ISpeak2myHouse/ISpeak2myHouseRoot/Mechanical/Mechanical Design.pptx

## Mechanical Design

Wearable Device

## Slide 2

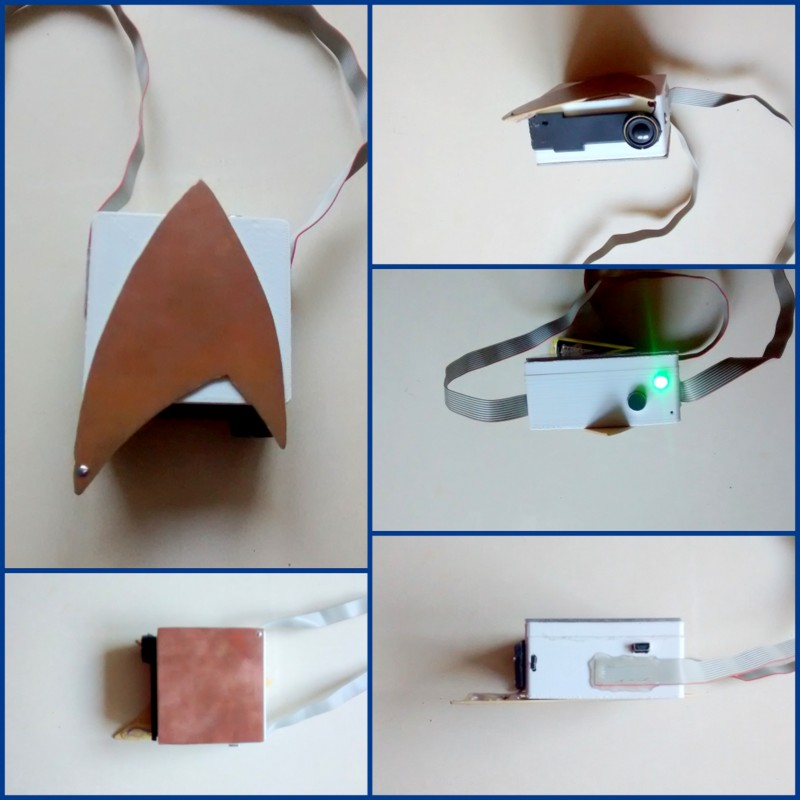
[picture p1: figure]

FRONT VIEW

BOTTOM VIEW

TOP VIEW
(with LED)

BACK VIEW

SIDE VIEW
