ISpeak2myHouse/ISpeak2myHouseRoot/Hardware/FINAL/PCBv1.3/01072016wearable_v1.3 - OK.html

Partlist exported from D:/Mes Documents/03 - Freiburg Universitaet/06 - Kurse/SS16/06 - Embedded Systems/02 - HW/01 - Wearable/FINAL/PCBv1.3/01072016wearable_v1.3 - OK.sch at 11/07/2016 17:32

Part | Value | Device | Package | Description | MF | MPN | OC_FARNELL | OC_NEWARK
BAT | | MA03-1 | MA03-1 | PIN HEADER | | | unknown | unknown
BUTIN | LSP10 | LSP10 | LSP10 | SOLDER PAD drill 1.0 mm, distributor Buerklin, 12H555
C1 | 0.1u | C2.5/2 | C2.5-2 | CAPACITOR
C2 | 0.1u | C2.5/2 | C2.5-2 | CAPACITOR
CAPIN | LSP10 | LSP10 | LSP10 | SOLDER PAD drill 1.0 mm, distributor Buerklin, 12H555
D1 | BAT54C | BAT54C | SOT23 | Schottky Diodes
IC1 | NCS2211 | NCS2211 | SOIC-8
IC2 | TEENSY_3.1_OUTER_ROW | TEENSY_3.1_OUTER_ROW | TEENSY3-OUTER_ROW | Footprint for Teensy 3.1 or 3.2 board using all pin connections on the outer perimeter
LED1 | 5MMRGBLED | 5MMRGBLED | LED5MMRGB
LS+ | LSP10 | LSP10 | LSP10 | SOLDER PAD drill 1.0 mm, distributor Buerklin, 12H555
LS- | LSP10 | LSP10 | LSP10 | SOLDER PAD drill 1.0 mm, distributor Buerklin, 12H555
MIC_IN | | MA05 | 05PA | AMP QUICK CONNECTOR | | | unknown | unknown
NRF24 | | MA04-2 | MA04-2 | PIN HEADER | | | unknown | unknown
P7 | LSP10 | LSP10 | LSP10 | SOLDER PAD drill 1.0 mm, distributor Buerklin, 12H555
P8 | LSP10 | LSP10 | LSP10 | SOLDER PAD drill 1.0 mm, distributor Buerklin, 12H555
P10 | LSP10 | LSP10 | LSP10 | SOLDER PAD drill 1.0 mm, distributor Buerklin, 12H555
P18 | LSP10 | LSP10 | LSP10 | SOLDER PAD drill 1.0 mm, distributor Buerklin, 12H555
P23 | LSP10 | LSP10 | LSP10 | SOLDER PAD drill 1.0 mm, distributor Buerklin, 12H555
R1 | 20k | R-EU_0204/7 | 0204/7 | RESISTOR, European symbol
R2 | 100 | R-EU_0207/2V | 0207/2V | RESISTOR, European symbol
R3 | 100 | R-EU_0207/2V | 0207/2V | RESISTOR, European symbol
R4 | 100 | R-EU_0207/2V | 0207/2V | RESISTOR, European symbol
R5 | 10k | R-EU_0207/2V | 0207/2V | RESISTOR, European symbol
R6 | 10k | R-EU_0207/2V | 0207/2V | RESISTOR, European symbol
S1 | SWS002 | SWS002 | SMS-002 | SMD Dip Switch 2 pol.
SD1 | MICROSD_SF-MICROSD | MICROSD_SF-MICROSD | MICROSD_MICROSD
SW_IN1 | SE11 | SE11 | SE11 | SOLDER PAD RTM, drill 1,1mm, distributor Buerklin, 07F810
SW_IN2 | SE11 | SE11 | SE11 | SOLDER PAD RTM, drill 1,1mm, distributor Buerklin, 07F810
TRIMMER20K | | R-EU_0207/2V | 0207/2V | RESISTOR, European symbol
U$1 | TSOP4830 | TSOP4830 | TSOP18XX | IR Receiver and Demodulator
USB5V | LSP10 | LSP10 | LSP10 | SOLDER PAD drill 1.0 mm, distributor Buerklin, 12H555
