ISpeak2myHouse/ISpeak2myHouseRoot/Hardware/FINAL/02 - SolidWorks/Assemblage1.SLDASM

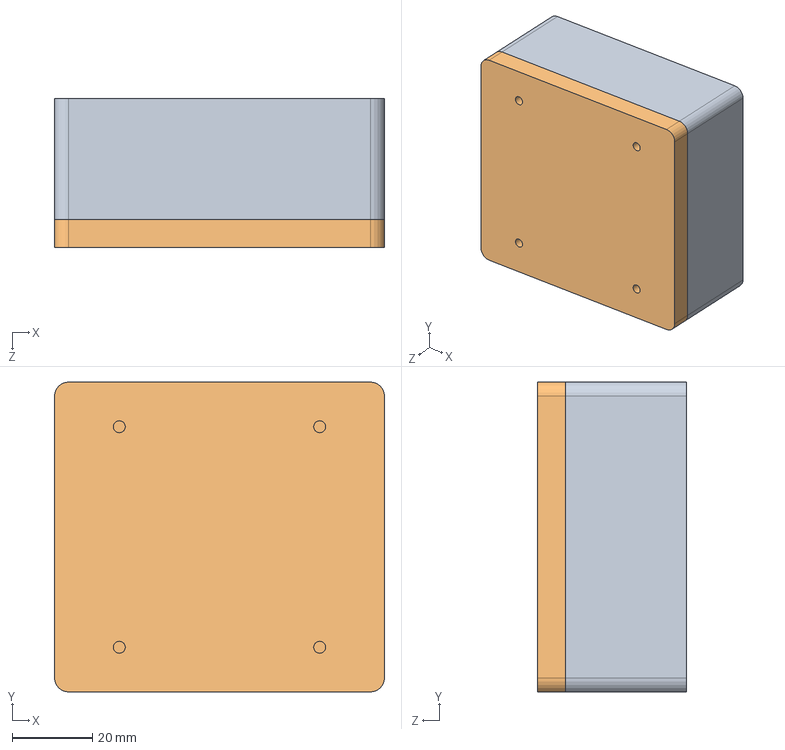
[picture p2: CAD file, 2016-08-07]
Hardware/FINAL/02 - SolidWorks/Assemblage1.SLDASM
82.0 x 77.0 x 37.0 mm
bottom
top
