ISpeak2myHouse/ISpeak2myHouseRoot/Hardware/FINAL/02 - SolidWorks/3D Printing/Ispeak2MyTop.STL

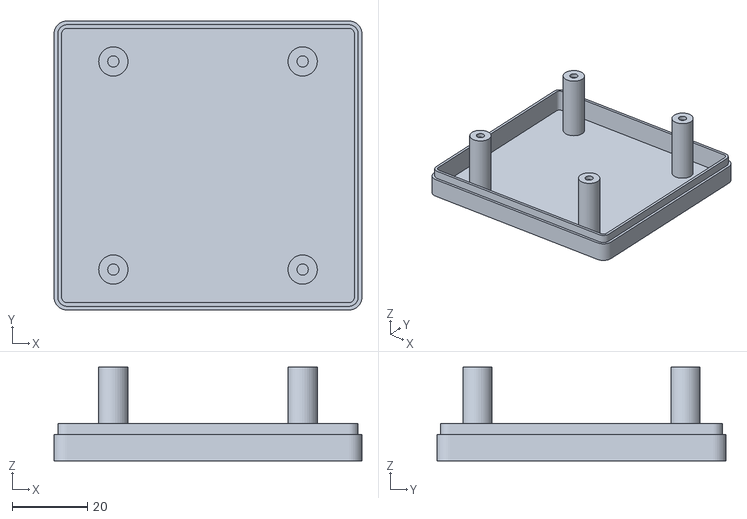
[picture p3: CAD file, 2016-08-07]
Hardware/FINAL/02 - SolidWorks/3D Printing/Ispeak2MyTop.STL
82.0 x 77.0 x 25.0
