ISpeak2myHouse/ISpeak2myHouseRoot/Hardware/FINAL/02 - SolidWorks/bottom.SLDPRT

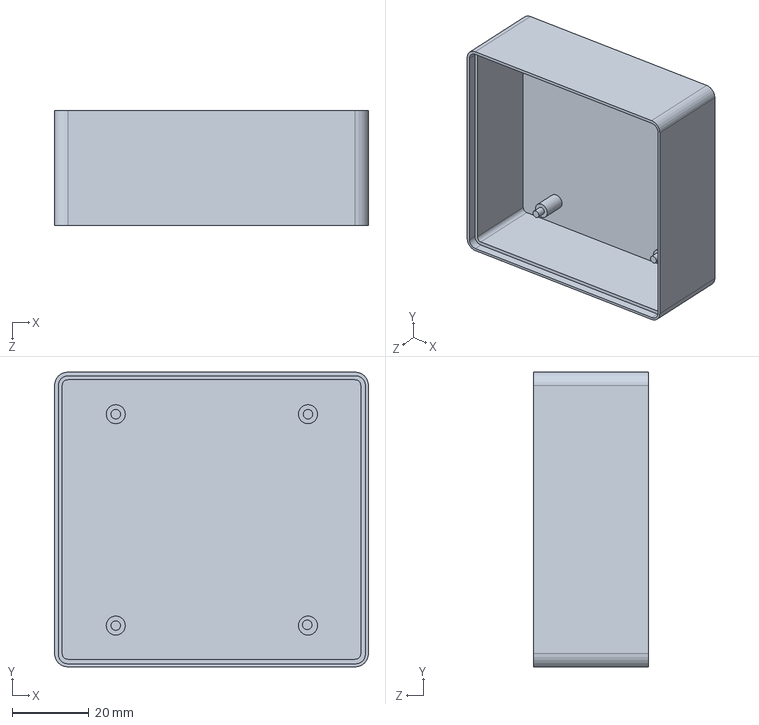
[picture p4: CAD file, 2016-08-07]
Hardware/FINAL/02 - SolidWorks/bottom.SLDPRT
82.0 x 77.0 x 30.0 mm
