ISpeak2myHouse/ISpeak2myHouseRoot/(list of files, cad)

Other CAD files:
Hardware/FINAL/02 - SolidWorks/top.SLDPRT
Hardware/FINAL/02 - SolidWorks/2D model.SLDDRW
Hardware/FINAL/02 - SolidWorks/3D Printing/bottom.STL
Hardware/FINAL/02 - SolidWorks/bottom.STL
Hardware/FINAL/02 - SolidWorks/top.STL
