ISpeak2myHouse/ISpeak2myHouseRoot/Hardware/FINAL/PCBv1.0/VIAs bottom view.pdf

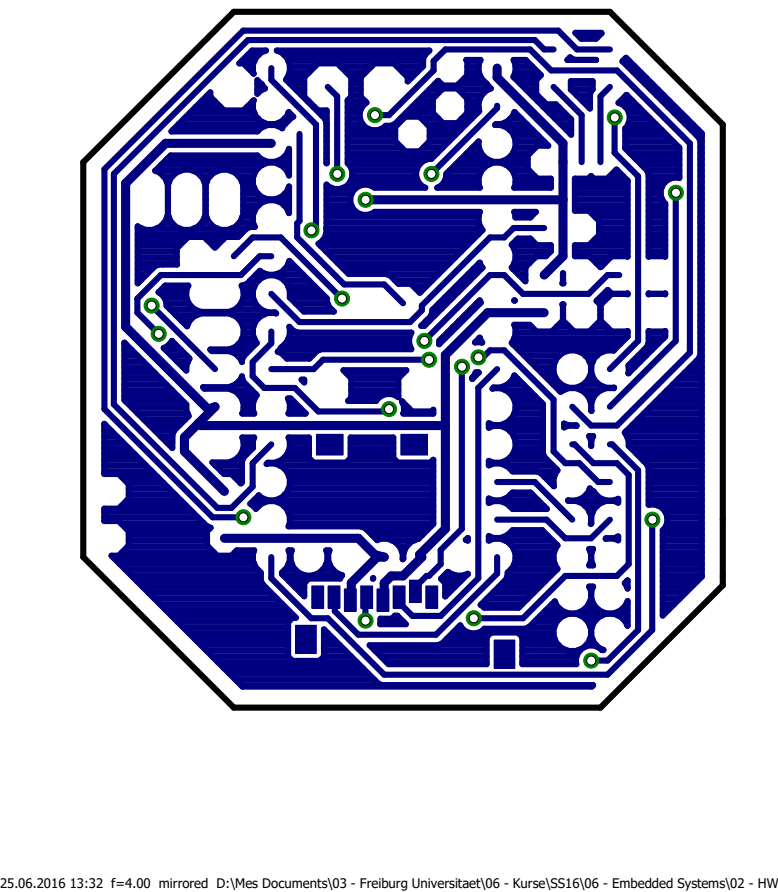
[picture p5: page 1]

25.06.2016 13:32 f=4.00 mirrored D:\Mes Documents\03 - Freiburg Universitaet\06 - Kurse\SS16\06 - Embedded Systems\02 - HW\01 - Wearable\FINAL\PCBv1.0\25062016wearable_v1.0.brd
