ISpeak2myHouse/ISpeak2myHouseRoot/Hardware/FINAL/PCBv1.0/VIAs top view.pdf

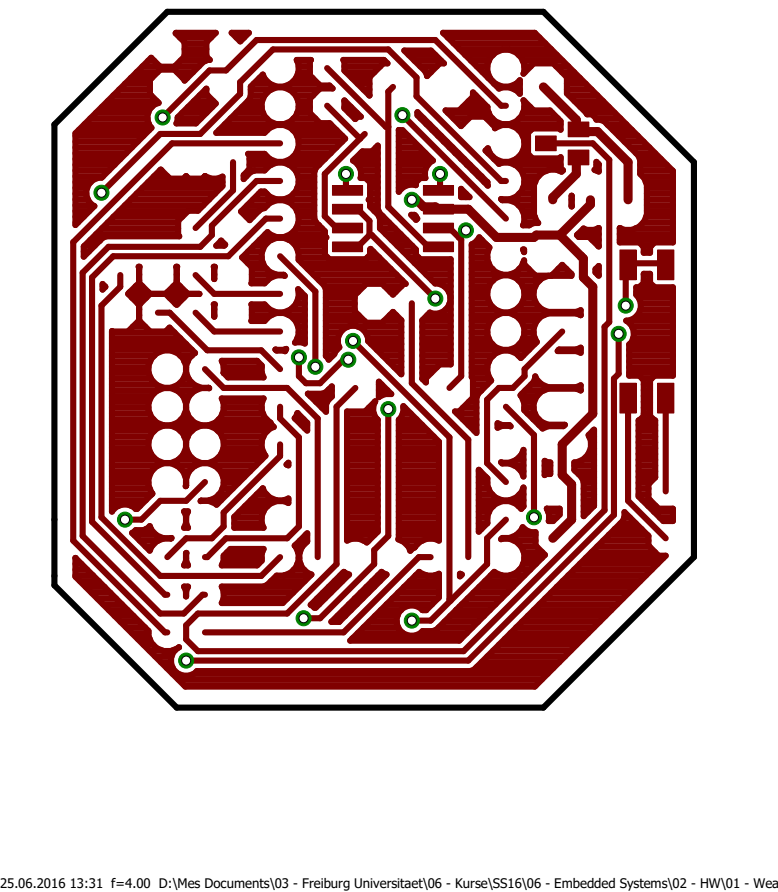
[picture p6: page 1]

25.06.2016 13:31 f=4.00 D:\Mes Documents\03 - Freiburg Universitaet\06 - Kurse\SS16\06 - Embedded Systems\02 - HW\01 - Wearable\FINAL\PCBv1.0\25062016wearable_v1.0.brd
