ISpeak2myHouse/ISpeak2myHouseRoot/Hardware/FINAL/PCBv1.0/wearable - components placement.pdf

# LED1

# LS+ LS- MIC_IN NRF24

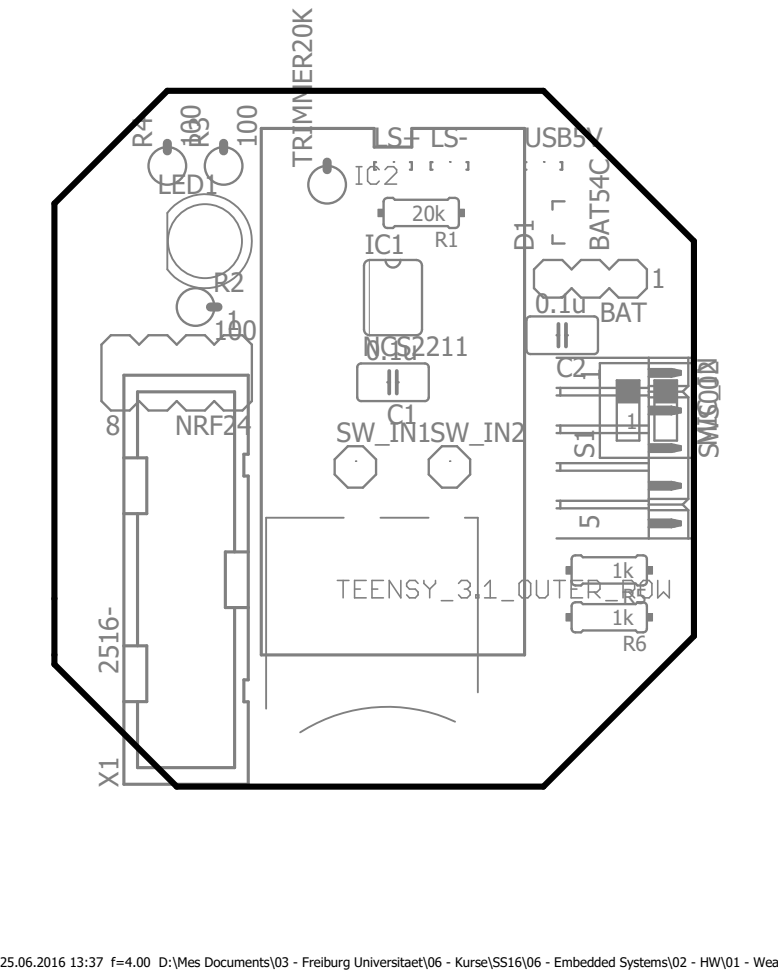
[picture p7: page 1]
BAT; R2 R⁴R³; SW_IN1SW_IN2 TRIMMER²⁰K; USB5V X1; 0.1u BAT54C; NCS2211; 100 ¹⁰⁰ ¹⁰⁰ 2516⁻; SWS002

25.06.2016 13:37 f=4.00 D:\Mes Documents\03 - Freiburg Universitaet\06 - Kurse\SS16\06 - Embedded Systems\02 - HW\01 - Wearable\FINAL\PCBv1.0\25062016wearable_v1.0.brd
