ISpeak2myHouse/ISpeak2myHouseRoot/Hardware/FINAL/PCBv1.0/wearable - Schematic.pdf

## IN- 4 EN

# X1-16 LS+ LS⁻ USB5V SW_IN¹ SW_IN²

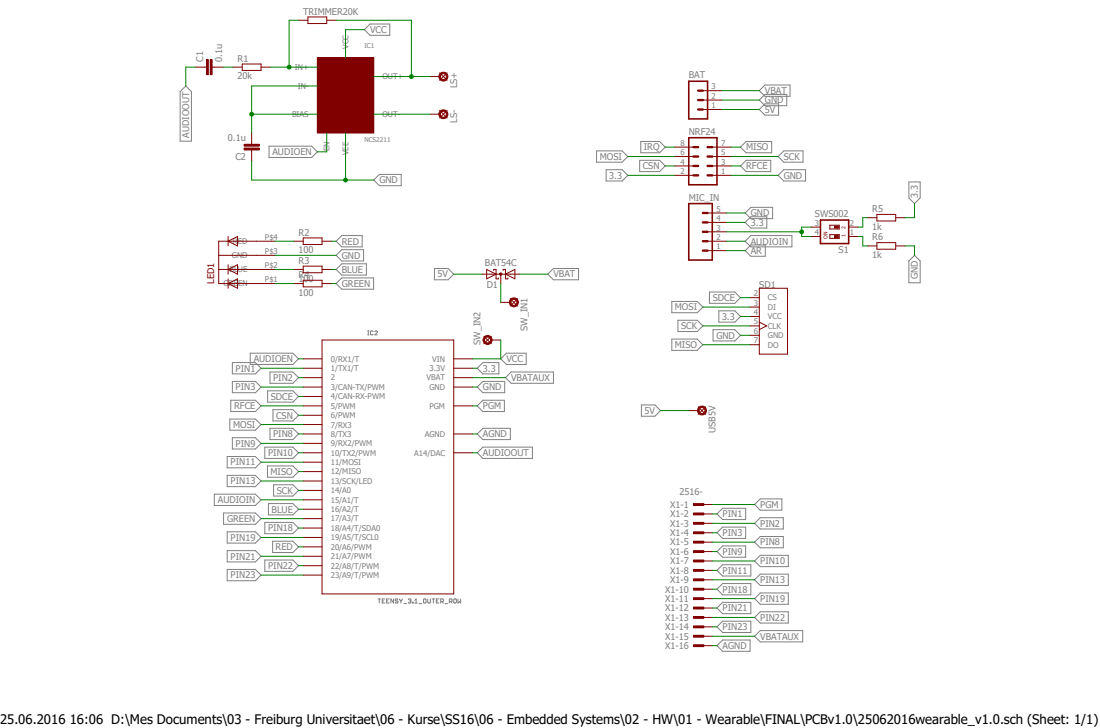
[picture p8: page 1]

25.06.2016 16:06 D:\Mes Documents\03 - Freiburg Universitaet\06 - Kurse\SS16\06 - Embedded Systems\02 - HW\01 - Wearable\FINAL\PCBv1.0\25062016wearable_v1.0.sch (Sheet: 1/1)
