ISpeak2myHouse/ISpeak2myHouseRoot/Hardware/FINAL/PCBv1.3/bottom.pdf

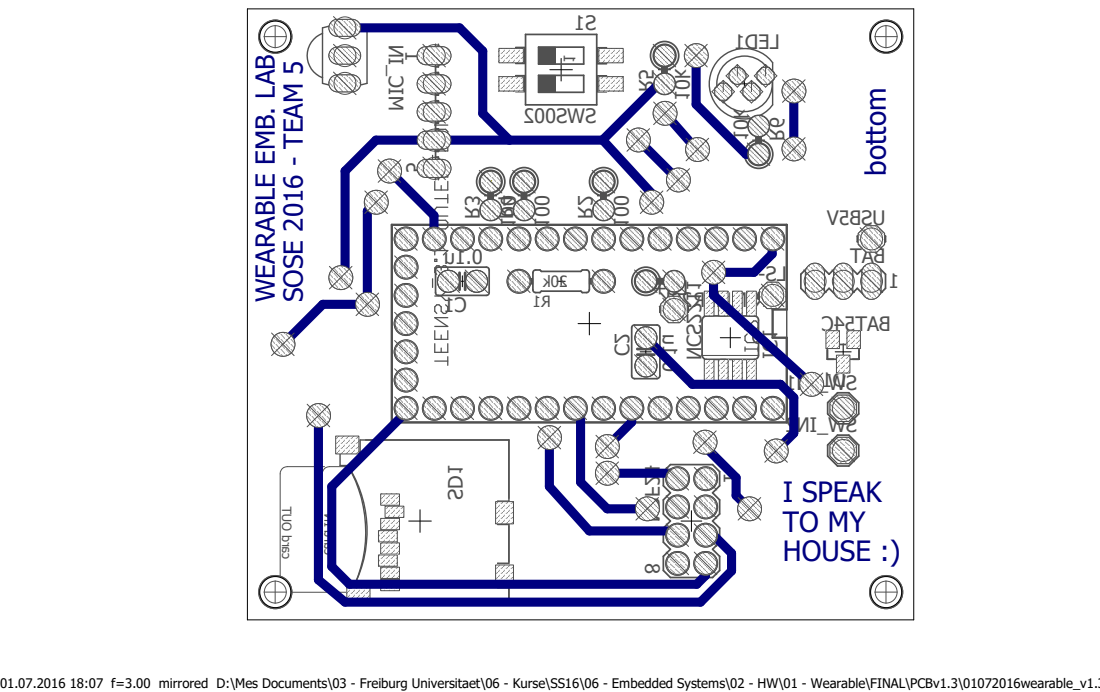
[picture p9: page 1]
I SPEAK TO MY HOUSE :)

1 bottom WEARABLE EMB. LAB SOSE 2016 - TEAM 5

01.07.2016 18:07 f=3.00 mirrored D:\Mes Documents\03 - Freiburg Universitaet\06 - Kurse\SS16\06 - Embedded Systems\02 - HW\01 - Wearable\FINAL\PCBv1.3\01072016wearable_v1.3 - OK.brd
