ISpeak2myHouse/ISpeak2myHouseRoot/Hardware/FINAL/PCBv1.3/Schematic.pdf

## IN- 4 EN

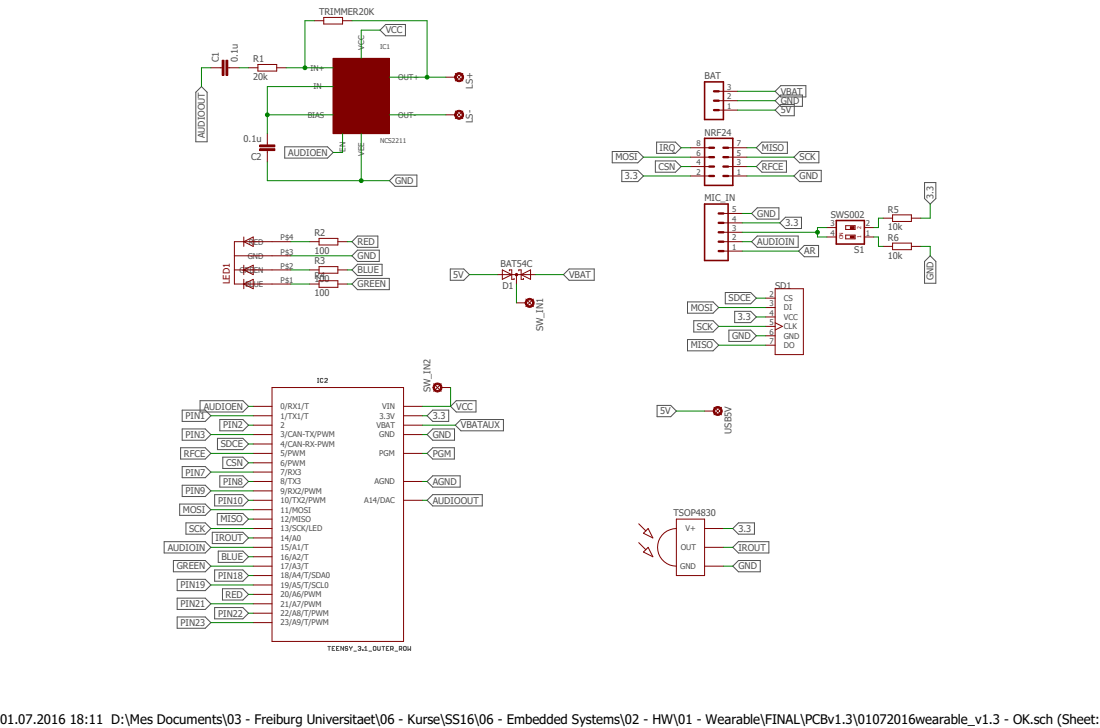
[picture p10: page 1]

01.07.2016 18:11 D:\Mes Documents\03 - Freiburg Universitaet\06 - Kurse\SS16\06 - Embedded Systems\02 - HW\01 - Wearable\FINAL\PCBv1.3\01072016wearable_v1.3 - OK.sch (Sheet: 1/1)
