ISpeak2myHouse/ISpeak2myHouseRoot/Hardware/FINAL/PCBv1.3/top.pdf

60.00

## LED1

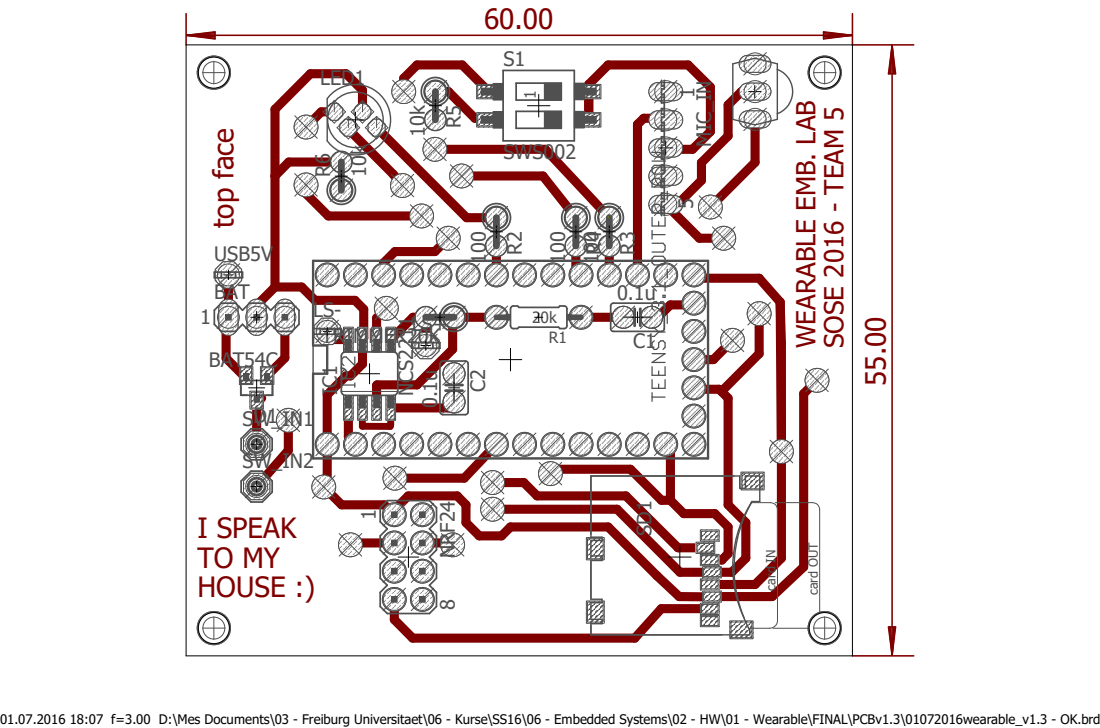
[picture p12: page 1]
01.07.2016 18:07 f=3.00 D:\Mes Documents\03 - Freiburg Universitaet\06 - Kurse\SS16\06 - Embedded Systems\02 - HW\01 - Wearable\FINAL\PCBv1.3\01072016wearable_v1.3 - OK.brd top face; WEARABLE EMB. LAB SOSE 2016 ⁻ TEAM ⁵ 55.00; I SPEAK TO MY HOUSE :); BAT; MIC_IN NRF24; R⁴R³ R⁵ R⁶; SD¹; TRIMMER20K; USB5V; BAT54C; NCS2211; 20k ¹⁰⁰; SWS002

1 card IN card OUT
