ISpeak2myHouse/ISpeak2myHouseRoot/Hardware/FINAL/02 - SolidWorks/final plan.pdf

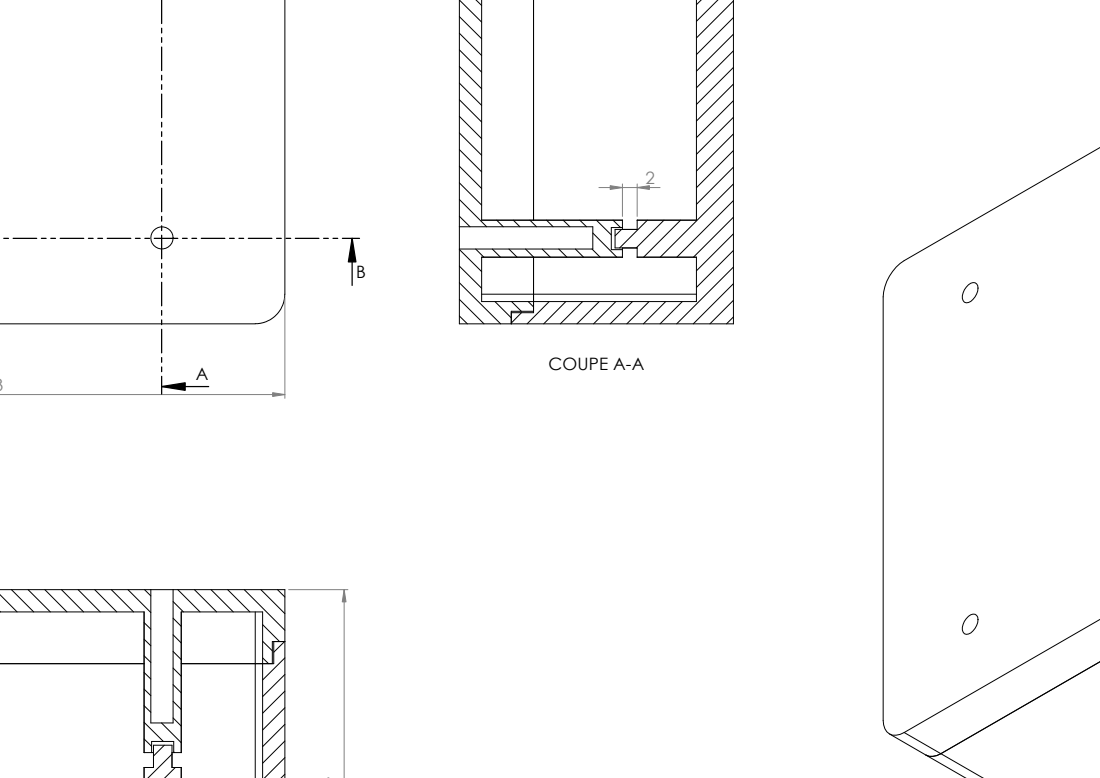
[picture p13: page 1]
COUPE A-A
