ISpeak2myHouse/ISpeak2myHouseRoot/LiFi transmission + schmitt trigger.asc

C1: cap; 0.1n
D2: schottky
R1: res; 50k
R2: res; 1k
R3: res; 3.3k
R4: res; 1k
R5: res; 100k
R6: res; 100k
R7: res; 50k
R8: res; 100k
U1: LT6202
U2: PC817C
U3: LT6202
V1: voltage; 3.3
V3: voltage; PULSE(0 0.1 0 0 0 0.0000005 0.000001 1000); AC 1
V4: voltage; PULSE(0 3.3 0 0 0 0.00005 0.0001 50)
Named nets: 0, V+, V-, Vin, Vk, Vout, Vschmitt
.tran 0.0002
