ISpeak2myHouse/ISpeak2myHouseRoot/Hardware/FINAL/PCBV1.1/25062016wearable_v1.2 - OK.brd

## EAGLE design Hardware/FINAL/PCBV1.1/25062016wearable_v1.2 - OK.brd (2016-08-07)

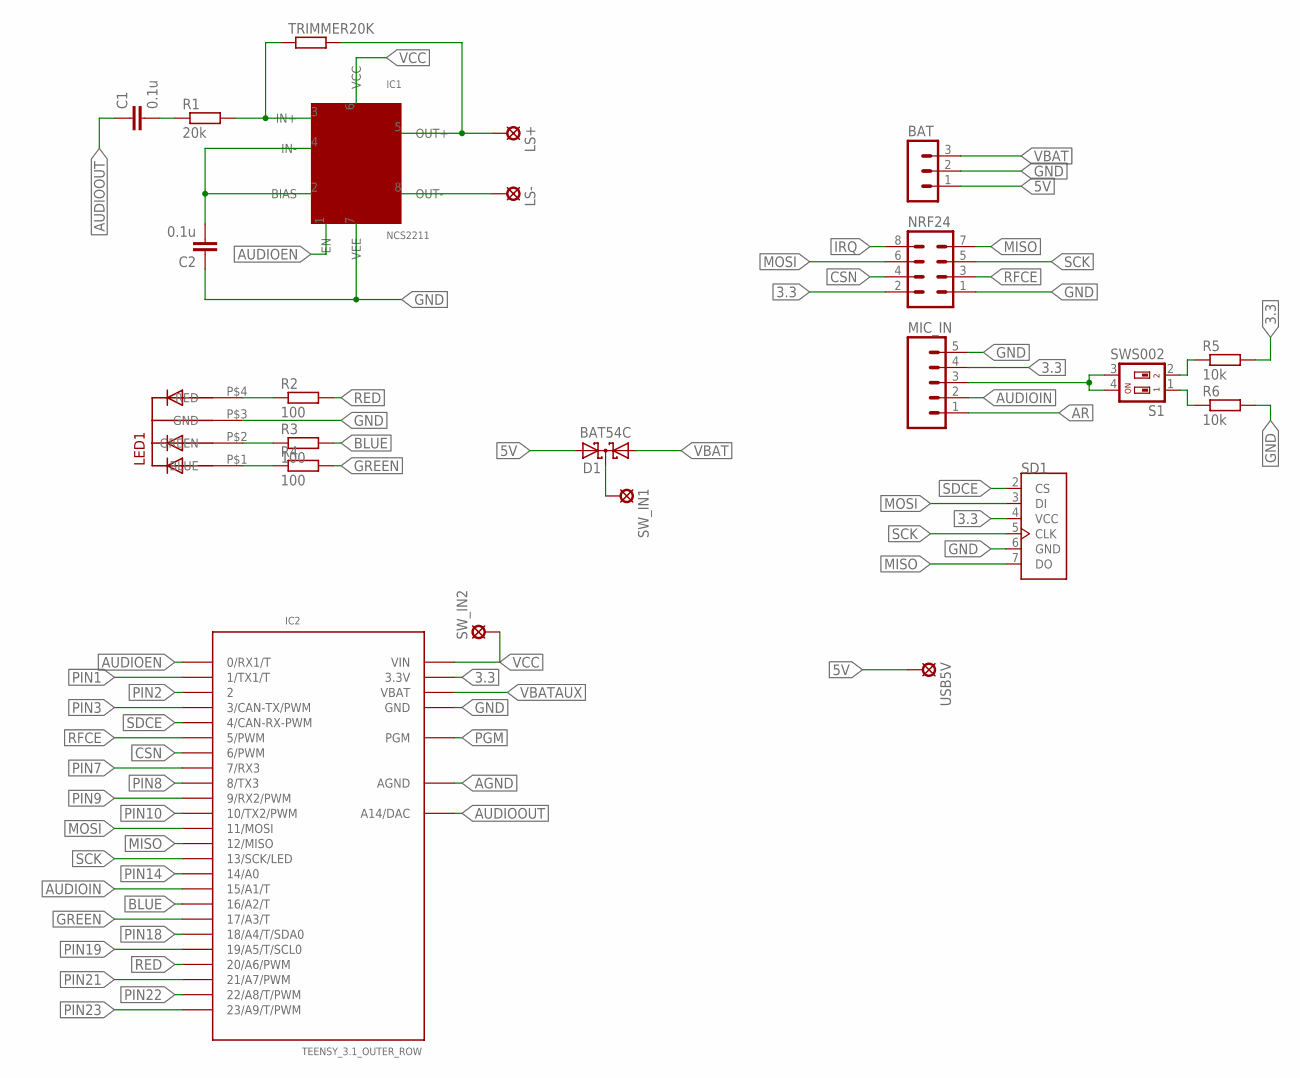
[picture p14: schematic 25062016wearable_v1.2 - OK.sch]

Parts:
BAT: MA03-1
C1, C2: 0.1u; C2.5-2
D1: BAT54C; SOT23
IC1: NCS2211; SOIC-8
IC2: TEENSY_3.1_OUTER_ROW; TEENSY3-OUTER_ROW
LED1: 5MMRGBLED; LED5MMRGB
LS+: LSP10
LS-: LSP10
MIC_IN: MA05; 05PA
NRF24: MA04-2
R1: 20k; 0204/7
R2, R3, R4: 100; 0207/2V
R5, R6: 10k; 0207/2V
S1: SWS002; SMS-002
SD1: MICROSD_SF-MICROSD; MICROSD_MICROSD
SW_IN1, SW_IN2: SE11
TRIMMER20K: R-EU_0207/2V; 0207/2V
USB5V: LSP10

Connections:
3.3: IC2.3.3V, IC2.3.3V1 (3.3V), MIC_IN.4, NRF24.2, R5.2, SD1.4 (VCC)
5V: BAT.1, D1.2 (A2), USB5V.MP
AGND: IC2.AGND
AR: MIC_IN.1
AUDIOEN: IC1.1 (EN), IC2.0 (0/RX1/T)
AUDIOIN: IC2.15/A1 (15/A1/T), MIC_IN.2
AUDIOOUT: C1.1, IC2.RESET/DAC (A14/DAC)
BLUE: IC2.16/A2 (16/A2/T), R3.2
CSN: IC2.6 (6/PWM), NRF24.4
GAIN: MIC_IN.3, S1.3, S1.4
GND: BAT.2, C2.1, IC1.7 (VEE), IC2.GND, IC2.GND1 (GND), LED1.P$3 (GND), MIC_IN.5, NRF24.1, R6.2, SD1.6 (GND)
GREEN: IC2.17/A3 (17/A3/T), R4.2
IRQ: NRF24.8
MISO: IC2.12 (12/MISO), NRF24.7, SD1.7 (DO)
MOSI: IC2.11 (11/MOSI), NRF24.6, SD1.3 (DI)
unnamed: D1.3 (CC), SW_IN1.MP
unnamed: IC1.5 (OUT+), LS+.MP, TRIMMER20K.2
unnamed: IC1.3 (IN+), R1.2, TRIMMER20K.1
unnamed: C1.2, R1.1
unnamed: C2.2, IC1.2 (BIAS), IC1.4 (IN-)
unnamed: IC1.8 (OUT-), LS-.MP
unnamed: LED1.P$4 (RED), R2.1
unnamed: LED1.P$1 (BLUE), R4.1
unnamed: LED1.P$2 (GREEN), R3.1
unnamed: R5.1, S1.2
unnamed: R6.1, S1.1
PGM: IC2.PGM
PIN1: IC2.1 (1/TX1/T)
PIN2: IC2.2
PIN3: IC2.3 (3/CAN-TX/PWM)
PIN7: IC2.7 (7/RX3)
PIN8: IC2.8 (8/TX3)
PIN9: IC2.9 (9/RX2/PWM)
PIN10: IC2.10 (10/TX2/PWM)
PIN14: IC2.14/A0
PIN18: IC2.18/A4 (18/A4/T/SDA0)
PIN19: IC2.19/A5 (19/A5/T/SCL0)
PIN21: IC2.21/A7 (21/A7/PWM)
PIN22: IC2.22/A8 (22/A8/T/PWM)
PIN23: IC2.23/A9 (23/A9/T/PWM)
RED: IC2.20/A6 (20/A6/PWM), R2.2
RFCE: IC2.5 (5/PWM), NRF24.3
SCK: IC2.13 (13/SCK/LED), NRF24.5, SD1.5 (CLK)
SDCE: IC2.4 (4/CAN-RX-PWM), SD1.2 (CS)
VBAT: BAT.3, D1.1 (A1)
VBATAUX: IC2.VBAT
VCC: IC1.6 (VCC), IC2.VIN, SW_IN2.MP

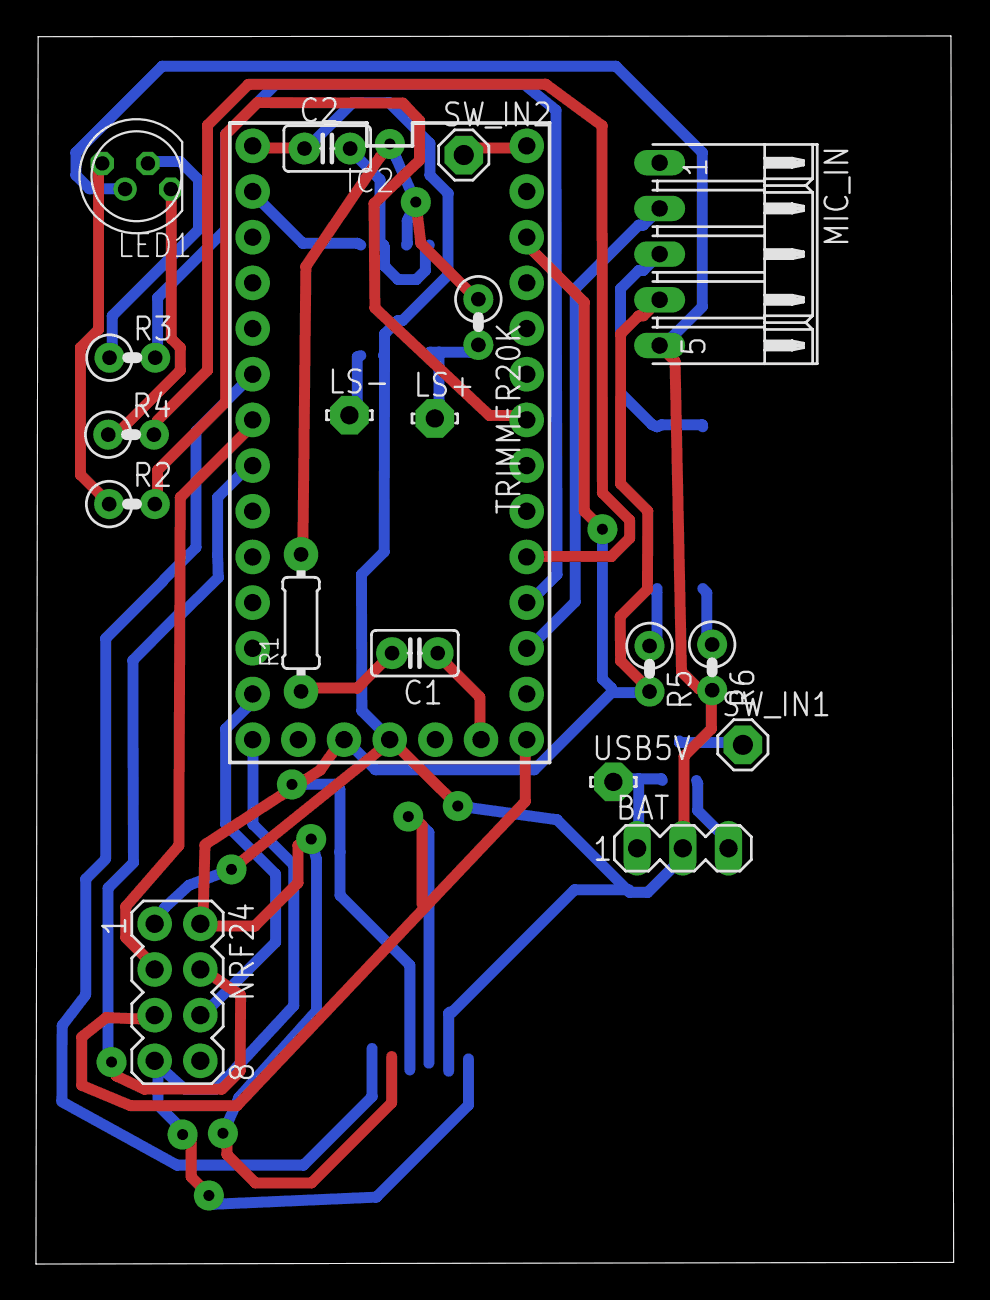
[picture p15: board 25062016wearable_v1.2 - OK.brd from above]

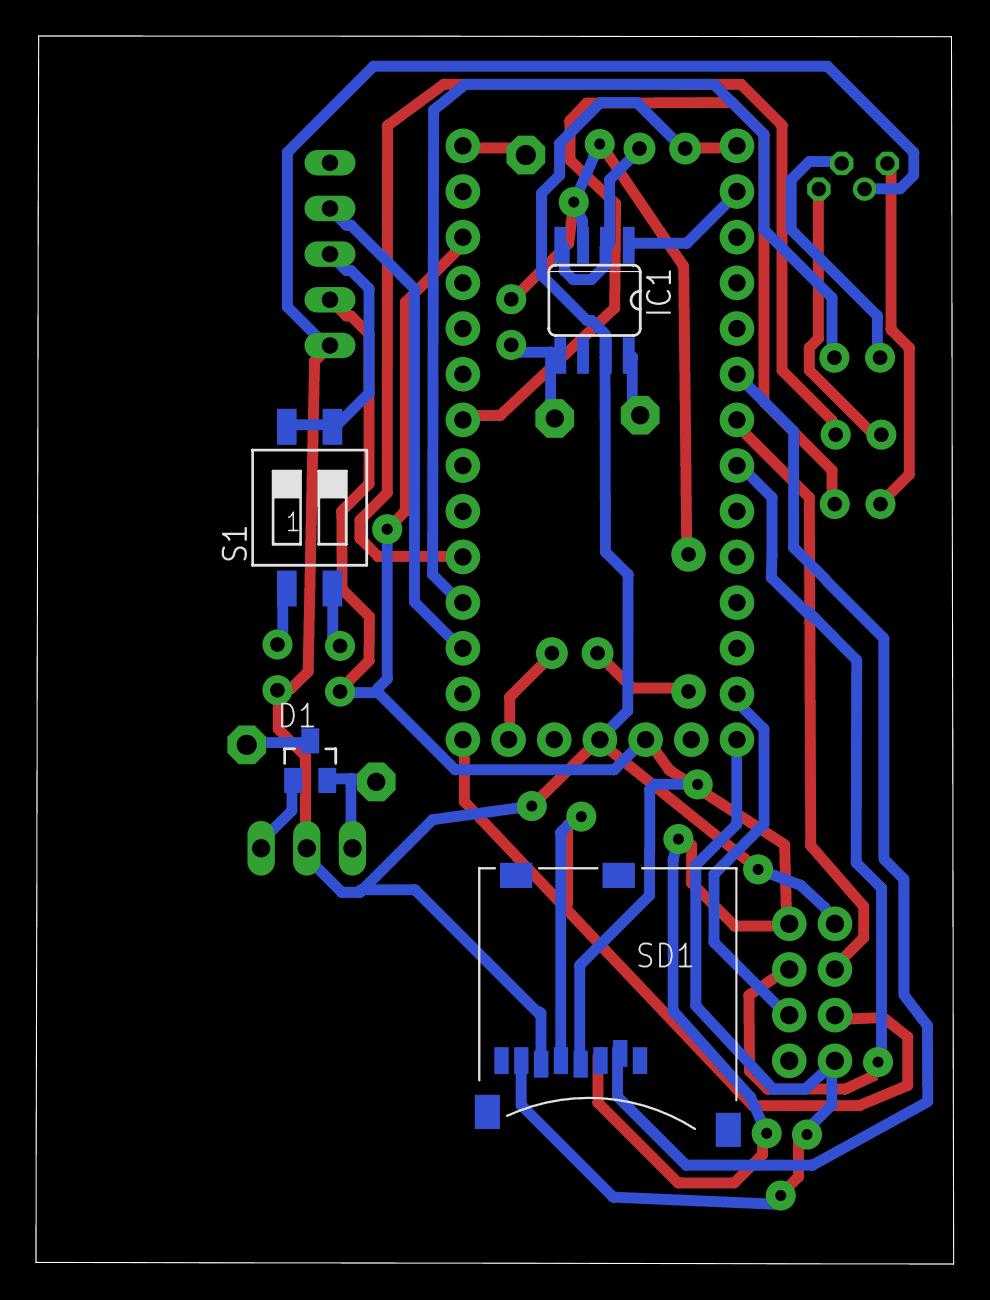
[picture p16: board 25062016wearable_v1.2 - OK.brd from below]

Board: 2 copper layers, 51.0 x 68.3 mm, 23 parts (4 on the bottom side), 29 nets.
