ISpeak2myHouse/ISpeak2myHouseRoot/(commit log)

2016-06-06 Code detects touch with a debounce and works only for the GREENLED case
2016-06-08 new logit written for all the touch cases with switch
2016-06-08 working for 1 case
2016-06-08 going into all the case loops but switching back before action could be executed
